AlessioCaligiuri/RF_Project/Relazione/immagini/sistemaRFCommentato.PNG

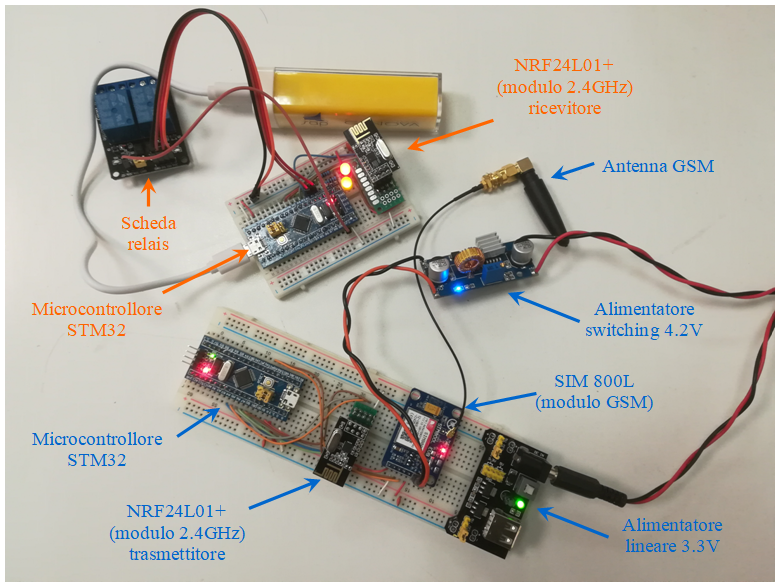
Relazione/immagini/sistemaRFCommentato.PNG
