AlessioCaligiuri/RF_Project/Relazione/immagini/sim800.jpg

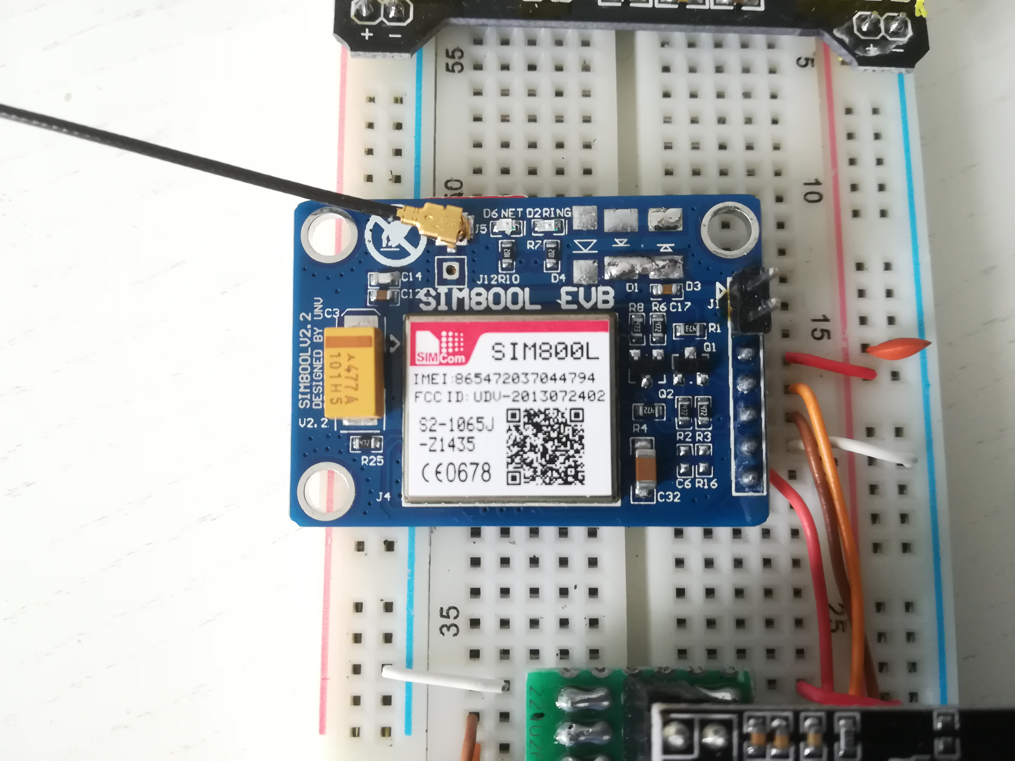
Relazione/immagini/sim800.jpg
