AlessioCaligiuri/RF_Project/Relazione/immagini/baseStation.jpg

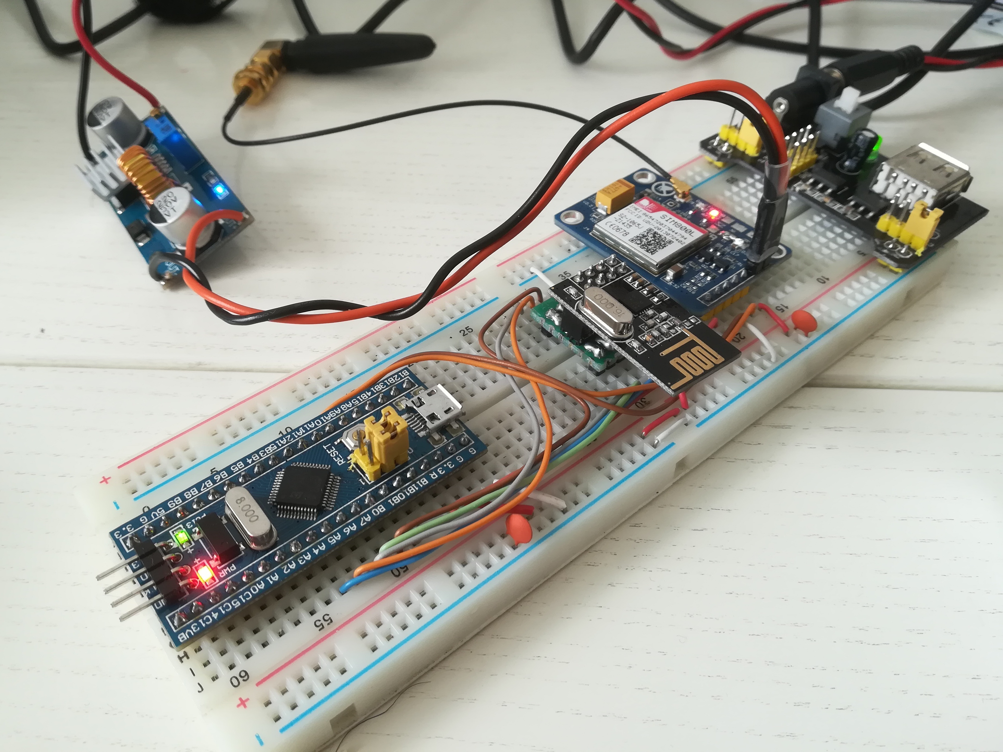
Relazione/immagini/baseStation.jpg
