AlessioCaligiuri/RF_Project/Relazione/immagini/remoteUnit.jpg

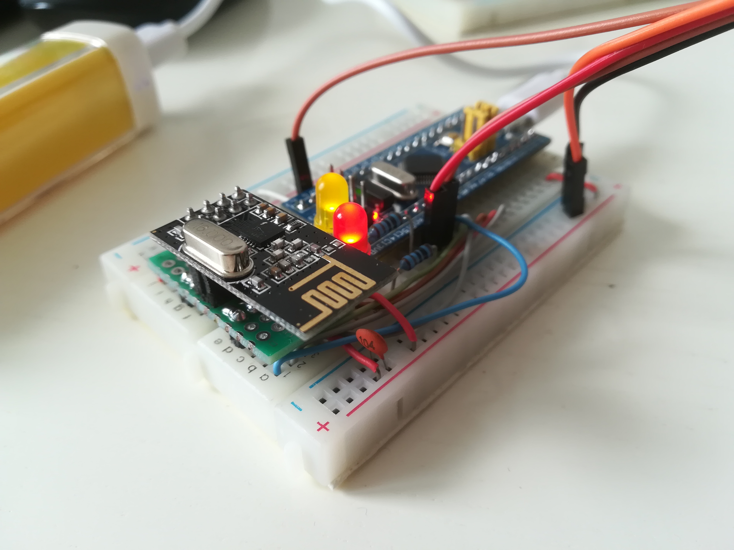
Relazione/immagini/remoteUnit.jpg
