AlessioCaligiuri/RF_Project/Relazione/immagini/RF_RemoteUnit(1).png

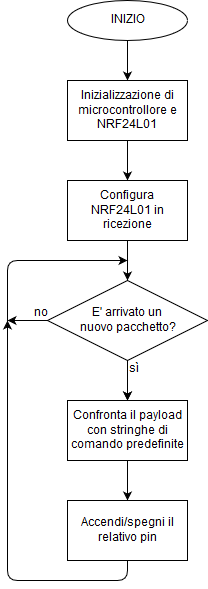
Relazione/immagini/RF_RemoteUnit(1).png
