AlessioCaligiuri/RF_Project/Schemi/large_current_relay_pro1.png

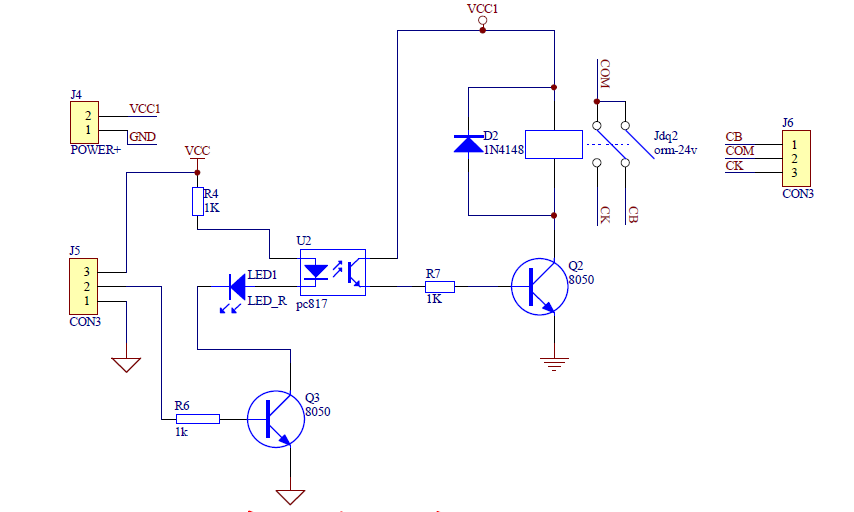
Schemi/large_current_relay_pro1.png
