AlessioCaligiuri/RF_Project/(list of files, drawings)

Other design files:
Schemi/BaseStation.fzz
Schemi/RemoteUnit.fzz
