AlessioCaligiuri/RF_Project/STM32_Workspace/STM32F103_NRF24L01_rx/src/main.c

/**
  ******************************************************************************
  * File Name          : main.c
  * Description        : Main program body
  ******************************************************************************
  *
  * COPYRIGHT(c) 2018 STMicroelectronics
  *
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
  ******************************************************************************
  */
/* Includes ------------------------------------------------------------------*/
#include "main.h"
#include "stm32f1xx_hal.h"
#include "spi.h"
#include "usart.h"
#include "gpio.h"
#include "nrf24l01.h"


/* USER CODE BEGIN PV */

/* USER CODE END PV */

void SystemClock_Config(void);
void Error_Handler(void);

/* USER CODE BEGIN PFP */

/* USER CODE END PFP */

/* USER CODE BEGIN 0 */
static void error()
{
    while (1)
    {
        HAL_GPIO_TogglePin(LED_ONBOARD_GPIO_Port, LED_ONBOARD_Pin);
        HAL_Delay(100);
    }
}

static const uint8_t rx_address[5] = {1, 2, 3, 4, 6};
static const uint8_t tx_address[5] = {1, 2, 3, 4, 5};
nrf24l01 nrf;

void nrf24l01_example()
{
  uint32_t rx_data;

  {
	  nrf24l01_config config;
	  config.data_rate        = NRF_DATA_RATE_1MBPS;
	  config.tx_power         = NRF_TX_PWR_0dBm;
	  config.crc_width        = NRF_CRC_WIDTH_1B;
	  config.addr_width       = NRF_ADDR_WIDTH_5;
	  config.payload_length   = 32;    // maximum is 32 bytes
	  config.retransmit_count = 15;   // maximum is 15 times
	  config.retransmit_delay = 0x0F; // 4000us, LSB:250us
	  config.rf_channel       = 0;
	  config.rx_address       = rx_address;
	  config.tx_address       = tx_address;
	  config.rx_buffer        = (uint8_t*)&rx_data;

	  config.spi         = &hspi1;
	  config.spi_timeout = 10; // milliseconds
	  config.ce_port     = NRF_CE_GPIO_Port;
	  config.ce_pin      = NRF_CE_Pin;
	  config.irq_port    = NRF_IRQ_GPIO_Port;
	  config.irq_pin     = NRF_IRQ_Pin;
	  config.csn_port	 = NRF_CSN_GPIO_Port;
	  config.csn_pin	 = NRF_CSN_Pin;




	  nrf_init(&nrf, &config);
  }




  //uint8_t tx_data[32] = "Emanuele ti voglio bene!! <3 <3";
  uint8_t tx_data = 'a';

  uint8_t rxData[32];

  while (1)
  {
 		memcpy(rxData,nrf_receive_packet(&nrf), sizeof(rxData));
 		HAL_GPIO_TogglePin(LED_ONBOARD_GPIO_Port,LED_ONBOARD_Pin);


		if (!strcmp(rxData, "Turn ON red LED!"))
		  HAL_GPIO_WritePin(LED_RED_GPIO_Port,LED_RED_Pin,GPIO_PIN_RESET);
		else if (!strcmp(rxData, "Turn OFF red LED!"))
		  HAL_GPIO_WritePin(LED_RED_GPIO_Port,LED_RED_Pin,GPIO_PIN_SET);
		else if (!strcmp(rxData, "Turn ON yellow LED!"))
		  HAL_GPIO_WritePin(LED_YELLOW_GPIO_Port,LED_YELLOW_Pin,GPIO_PIN_RESET);
		else if (!strcmp(rxData, "Turn OFF yellow LED!"))
		  HAL_GPIO_WritePin(LED_YELLOW_GPIO_Port,LED_YELLOW_Pin,GPIO_PIN_SET);
		else if (!strcmp(rxData, "Turn OFF yellow LED!"))
		  HAL_GPIO_WritePin(LED_YELLOW_GPIO_Port,LED_YELLOW_Pin,GPIO_PIN_SET);
		else if (!strcmp(rxData, "Accendi cantiere! "))
		  HAL_GPIO_WritePin(RELAIS_2_GPIO_Port,RELAIS_2_Pin,GPIO_PIN_RESET);
		else if (!strcmp(rxData, "Spegni cantiere! "))
		  HAL_GPIO_WritePin(RELAIS_2_GPIO_Port,RELAIS_2_Pin,GPIO_PIN_SET);
  }



//  while (1)
//  {
//	  nrf_receive_packet(&nrf);
//	  if (tx_data != rx_data)
//		  error();
//	  HAL_GPIO_TogglePin(LED_GPIO_Port, LED_Pin);
//	  HAL_Delay(500);
//	  HAL_GPIO_TogglePin(LED_GPIO_Port, LED_Pin);
//  }
}

/* USER CODE END 0 */

void HAL_GPIO_EXTI_Callback(uint16_t GPIO_Pin)
{
	nrf_irq_handler(&nrf);
}


int main(void)
{

  /* MCU Configuration----------------------------------------------------------*/

  /* Reset of all peripherals, Initializes the Flash interface and the Systick. */
  HAL_Init();

  /* Configure the system clock */
  SystemClock_Config();

  /* Initialize all configured peripherals */
  MX_GPIO_Init();
  MX_USART1_UART_Init();
  MX_SPI1_Init();

  /* USER CODE BEGIN 2 */
  nrf24l01_example();
  /* USER CODE END 2 */

  /* Infinite loop */
  /* USER CODE BEGIN WHILE */
  while (1)
  {
  /* USER CODE END WHILE */
	  //



  /* USER CODE BEGIN 3 */

  }
  /* USER CODE END 3 */

}

/** System Clock Configuration
*/
void SystemClock_Config(void)
{

  RCC_OscInitTypeDef RCC_OscInitStruct;
  RCC_ClkInitTypeDef RCC_ClkInitStruct;

    /**Initializes the CPU, AHB and APB busses clocks 
    */
  RCC_OscInitStruct.OscillatorType = RCC_OSCILLATORTYPE_HSI;
  RCC_OscInitStruct.HSIState = RCC_HSI_ON;
  RCC_OscInitStruct.HSICalibrationValue = 16;
  RCC_OscInitStruct.PLL.PLLState = RCC_PLL_NONE;
  if (HAL_RCC_OscConfig(&RCC_OscInitStruct) != HAL_OK)
  {
    Error_Handler();
  }

    /**Initializes the CPU, AHB and APB busses clocks 
    */
  RCC_ClkInitStruct.ClockType = RCC_CLOCKTYPE_HCLK|RCC_CLOCKTYPE_SYSCLK
                              |RCC_CLOCKTYPE_PCLK1|RCC_CLOCKTYPE_PCLK2;
  RCC_ClkInitStruct.SYSCLKSource = RCC_SYSCLKSOURCE_HSI;
  RCC_ClkInitStruct.AHBCLKDivider = RCC_SYSCLK_DIV1;
  RCC_ClkInitStruct.APB1CLKDivider = RCC_HCLK_DIV1;
  RCC_ClkInitStruct.APB2CLKDivider = RCC_HCLK_DIV1;

  if (HAL_RCC_ClockConfig(&RCC_ClkInitStruct, FLASH_LATENCY_0) != HAL_OK)
  {
    Error_Handler();
  }

    /**Configure the Systick interrupt time 
    */
  HAL_SYSTICK_Config(HAL_RCC_GetHCLKFreq()/1000);

    /**Configure the Systick 
    */
  HAL_SYSTICK_CLKSourceConfig(SYSTICK_CLKSOURCE_HCLK);

  /* SysTick_IRQn interrupt configuration */
  HAL_NVIC_SetPriority(SysTick_IRQn, 0, 0);
}

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
