AlessioCaligiuri/RF_Project/STM32_CubeMx/STM32F103_RemoteUnit/STM32F103_RemoteUnit.ioc

Mcu.UserName=STM32F103C8Tx
PA10.GPIO_Label=USART1_RX_PC
PA10.Signal=USART1_RX
PA4.GPIO_Label=NRF_CSN
PA4.Signal=GPIO_Output
PA5.GPIO_Label=NRF_SCK
PA5.Signal=SPI1_SCK
PA6.GPIO_Label=NRF_MISO
PA6.Signal=SPI1_MISO
PA7.GPIO_Label=NRF_MOSI
PA7.Signal=SPI1_MOSI
PA9.GPIO_Label=USART1_TX_PC
PA9.Signal=USART1_TX
PB0.GPIO_Label=NRF_CE
PB0.Signal=GPIO_Output
PB1.GPIO_Label=NRF_IRQ
PB1.Signal=GPXTI1
PB9.GPIO_Label=LED_YELLOW
PB9.Signal=GPIO_Output
PC13-TAMPER-RTC.GPIO_Label=LED_ONBOARD
PC13-TAMPER-RTC.Signal=GPIO_Output
PC14-OSC32_IN.GPIO_Label=LED_RED
PC14-OSC32_IN.Signal=GPIO_Output
