AlessioCaligiuri/RF_Project/(commit log)

2018-08-27 Initial commit. Schematics of modules and test sketch to use Arduino and SIM800L. See Note.txt for details.
2018-08-28 Added STM32 project for Eclipse and for CubeMX
2018-08-28 Test with UARTs.
2018-08-28 Played with UART between STM32 and SIM800. Work in progress.
2018-09-03 Added projects to try the UART with interrupts (just started).
2018-09-03 Continued with the UART with interrupts. We wrote a personalized version of the HAL_Uart_ReceiveIT. To test.
2018-10-09 Solved problem with project UsartIT (debug was disabled in MSP_Init). Working example with EAC library!!! Yeeeee
    [main.c]
2018-10-18 Added communication with a second USART. Works with a wired connection between A2 (USART2 TX) and A3 (USART2 RX). USART1 is for PC.
2018-10-23 Bidirection communication between PC-STM32-SIM800L works. Added callbacks in the ended tx. USART error handler to modify.
    [main.c]
2018-11-06 Added STM32F103 project for testing with NRF24L01. Problems with power up function; maybe CSN issue.
    [STM32F103_NRF24L01.ioc, main.c, main.h, nrf24l01.c, nrf24l01.h]
2018-11-18 Updated Eclipse Project and CubeMX project. CSN line manually driven. Added interrupt functions for NRF24 IRQ. Added notes from datasheet. Not working.
    [STM32F103_NRF24L01.ioc, main.c, main.h, nrf24l01.c]
2018-11-18 Added STM32F103_NRF24L01_rx project. It works with the corresponding STM32F103_NRF24L01(_tx).
2018-11-20 Parsed verified and "simulated" with PuTTY: it works. Project is STM32F103_BaseStation.
2018-11-22 Added board schemes.
    [BaseStation.fzz, RemoteUnit.fzz]
2018-11-22 Added expected final code to STM32F103_BaseStation project. Not working, for now.
    [main.c, nrf24l01.c, sim_parser.c]
2018-11-24 Updated remote unit. BEWARE! The correct project is NRF24L01_rx. RemoteUnit doesn't work (maybe EXTI2 priority).
    [main.c, main.h]
2018-11-24 Added images and schematic for report.
2018-11-24 Working on AlessioCaligiuri_EmanueleAnfuso_RelazioneRFMicroelectronics.docx.
    [RemoteUnit.fzz]
