AlessioCaligiuri/RF_Project/(notices)

Notices in the files:
STM32_Workspace/STM32F103_NRF24L01_rx/src/main.c:
(C) COPYRIGHT STMicroelectronics *****END OF FILE
